SuperPower/Apollo/apollo-board_TPS63060/layout.md

#### Top Layer



#### Bottom Layer
