SuperPower/Apollo/apollo-board_TPS63060/manufacturing/BOM/BOM.xlsx

References | Qty | Value | Footprint | DNP
C1, C2 | 2 | CC0603JRX7R9BB104 | C_0603_1608Metric
C14, C15 | 2 | 2.2μF | C_0603_1608Metric
C22, C23 | 2 | CL10B104KB8NNNC | C_0603_1608Metric
C24, C25 | 2 | CC0603JRNPO9BN100 | C_0603_1608Metric
C4 | 1 | CL10B105KO8NNNC | C_0603_1608Metric
C5 | 1 | CL10B223KB8NNNC | C_0603_1608Metric
C8 | 1 | 0.1µF | C_0603_1608Metric
C16, C17, C18, C19, C20, C21 | 6 | CL21A106KAYNNNE | C_0805_2012Metric
C26, C27, C28, C29, C30, C31 | 6 | CL21A226MAQNNNE | C_0805_2012Metric
C3 | 1 | TMK212AB7475KG-T | C_0805_2012Metric
C6, C7 | 2 | CL31B106KAHNNNE | C_1206_3216Metric
R11, R17, R25, R26, R41, R42, R43, R46, R48, R51 | 10 | 1M | R_0603_1608Metric
R9, R19, R39, R54, R55 | 5 | 390k | R_0603_1608Metric
R2, R4, R18 | 3 | DNP/0 | R_0603_1608Metric | DNP
R15, R16, R24 | 3 | 10k | R_0603_1608Metric
R6, R7 | 2 | 5.1k | R_0603_1608Metric
R21, R22 | 2 | 4.7k | R_0603_1608Metric
R23, R47 | 2 | 100k | R_0603_1608Metric
R3 | 1 | 2.7k | R_0603_1608Metric
R8 | 1 | 2.2k | R_0603_1608Metric
R10 | 1 | 12k | R_0603_1608Metric
R12 | 1 | DNP/2.2k | R_0603_1608Metric | DNP
R14 | 1 | 63.4k | R_0603_1608Metric
R49 | 1 | 110k | R_0603_1608Metric
R50 | 1 | 560k | R_0603_1608Metric
R5, R20 | 2 | ERJ-6DSFR13V | R_0805_2012Metric
R1 | 1 | ERJ-P06F4700V | R_0805_2012Metric
R13 | 1 | RL0805FR-7W0R068L | R_0805_2012Metric
L2, L3 | 2 | SPM6530T-1R5M | L_TDK_SPM6530T
L1 | 1 | SPM6530T-4R7M | L_TDK_SPM6530T
D1 | 1 | DFLS230L | D_PowerDI-123
U5 | 1 | RV-3028-C7 | IC_RV-3028-C7
U4 | 1 | LTC4162EUFD-LAD | QFN-28-1EP_4x5mm_P0.5mm_EP2.65x3.65mm_ThermalVias
U6 | 1 | TPS70933DBV | SOT-23-5
U1 | 1 | AP9101CK6-AYTRG1 | SOT-23-6
U3 | 1 | IP4220CZ6 | TSOP-6_1.65x3.05mm_P0.95mm
U9, U10 | 2 | TPS63060 | Texas_S-PWSON-N10_ThermalVias_NSM_vias_bottom
U2 | 1 | TYPE-C-31-M-12 | usb-c-usb4105
SW1 | 1 | SKRKAEE020 | SKRKAEE020
LED1 | 1 | 150060VS75000_0603 | LED_0603_1608Metric
LED2 | 1 | DNP/150060YS75000_0603 | LED_0603_1608Metric | DNP
JP2 | 1 | DNP/Jumper_NC_Small | PinSocket_1x02_P2.54mm_Vertical | DNP
Q4, Q9, Q10, Q11 | 4 | 2N7002A | SOT-23
Q3, Q15 | 2 | DMN3023L | SOT-23
Q6 | 1 | BSS84-7-F | SOT-23
Q5, Q12, Q13, Q14 | 4 | DMP2035UVT | SOT-23-6
Q2 | 1 | Si3421DV | TSOP-6_1.65x3.05mm_P0.95mm
Q1 | 1 | DMN2019UTS | TSSOP-8_4.4x3mm_P0.65mm
J1 | 1 | JST_PH_S2B_thru | JST_PH_S2B-PH-K_1x02_P2.00mm_Horizontal
J4 | 1 | DNP/JST_ZH_S2B_thru | PinHeader_1x02_P1.27mm_Vertical | DNP
J5 | 1 | DNP/JST_XH_S2B_thru | PinHeader_1x02_P2.54mm_Vertical | DNP
J6 | 1 | DNP/Conn_01x02_Male | PinSocket_1x02_P2.54mm_Vertical | DNP
J11 | 1 | DNP/Conn_01x04_Male | PinSocket_1x04_P2.54mm_Vertical | DNP
J10 | 1 | Conn_01x13_Male | PinSocket_1x13_P2.54mm_Vertical
