SuperPower/Apollo/components/DMP3028LSD/DMP3028LSD-13.stp

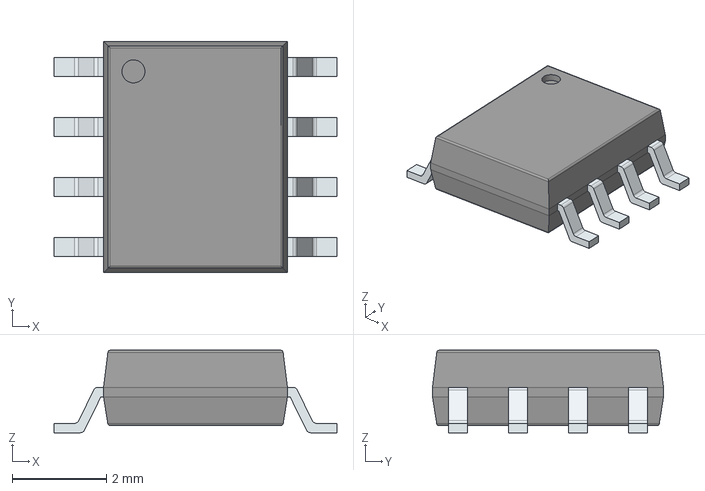
[picture p1: CAD file, 2021-02-21]
components/DMP3028LSD/DMP3028LSD-13.stp
6.00 x 4.90 x 1.75 mm
PinsArrayLR
