SuperPower/Apollo/components/PJ-102AH--3DModel-STEP-56544.STEP

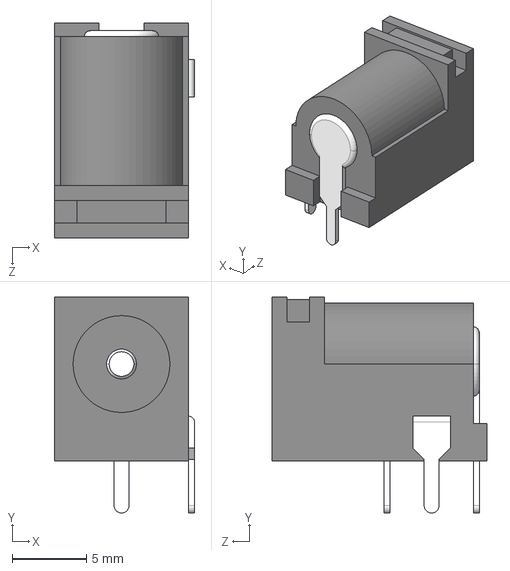
[picture p2: CAD file, 2021-02-21]
components/PJ-102AH--3DModel-STEP-56544.STEP
9.40 x 14.5 x 14.4 mm
