SuperPower/Apollo/components/RV-3028-C7/RV-3028-C7.STEP

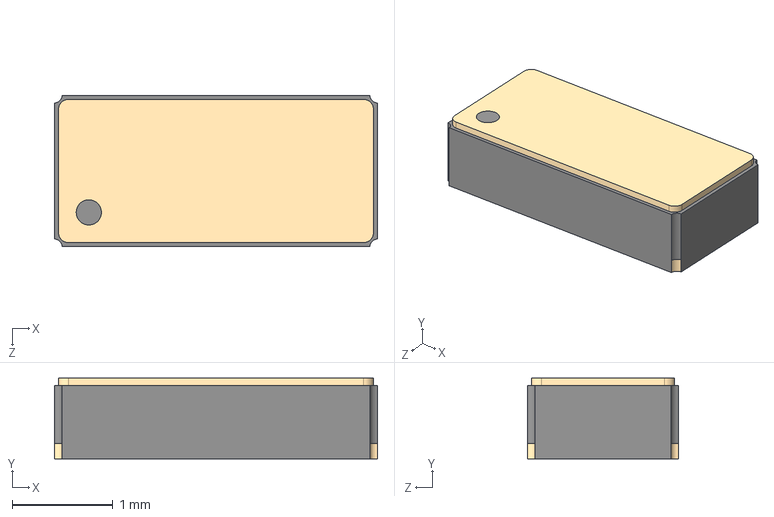
[picture p3: CAD file, 2021-02-21]
components/RV-3028-C7/RV-3028-C7.STEP
3.20 x 0.8 x 1.50 mm
