SuperPower/Apollo/components/SKRKAEE020/SKRKAEE020.stp

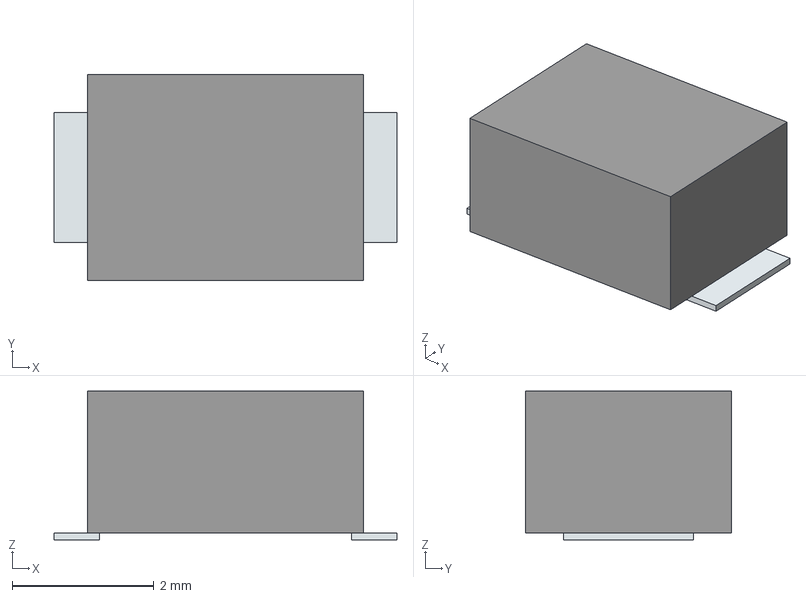
[picture p4: CAD file, 2021-02-21]
components/SKRKAEE020/SKRKAEE020.stp
4.84 x 2.90 x 2.10 mm
Pins
