SuperPower/Apollo/components/TPS63060/DSC0010E.stp

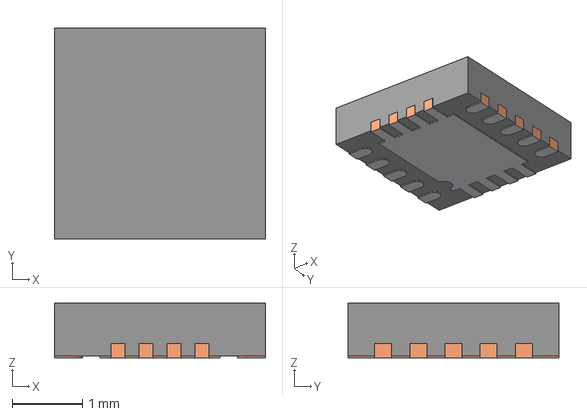
[picture p5: CAD file, 2021-02-28]
components/TPS63060/DSC0010E.stp
3.00 x 3.00 x 0.775 mm
BODY-SON
FRAME-DSC0010E
