SuperPower/Apollo/components/USB-C/USB4105.STEP

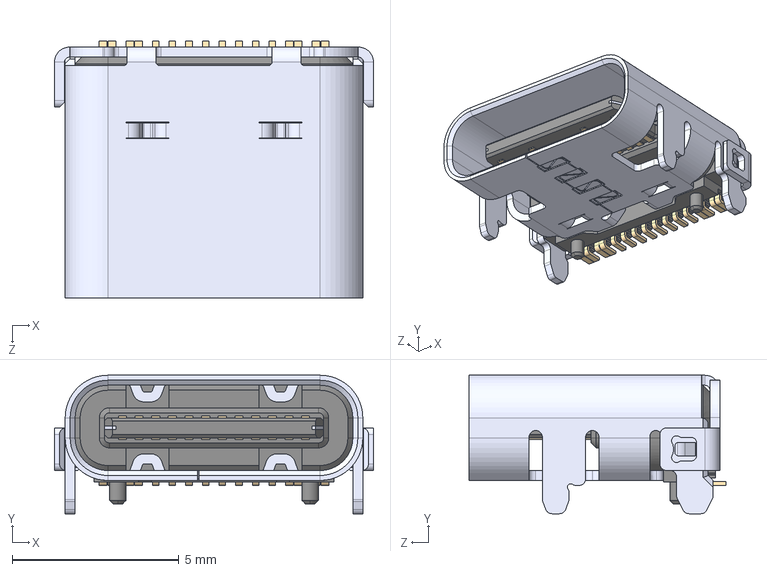
[picture p6: CAD file, 2021-02-21]
components/USB-C/USB4105.STEP
9.58 x 4.16 x 7.71 mm
