SuperPower/Apollo/components/SKRKAEE020/SKRKAE.STEP

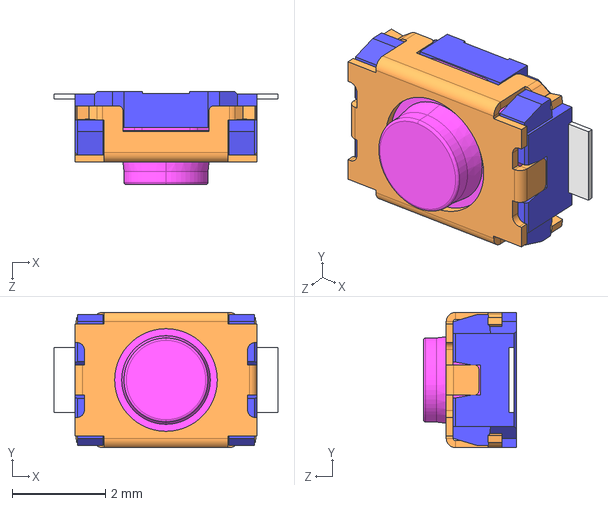
[picture p7: CAD file, 2021-02-21]
components/SKRKAEE020/SKRKAE.STEP
4.80 x 2.90 x 2.00 mm
