SuperPower/Apollo/components/USB-C/USB4110-GF-A--3DModel-STEP-56544.STEP

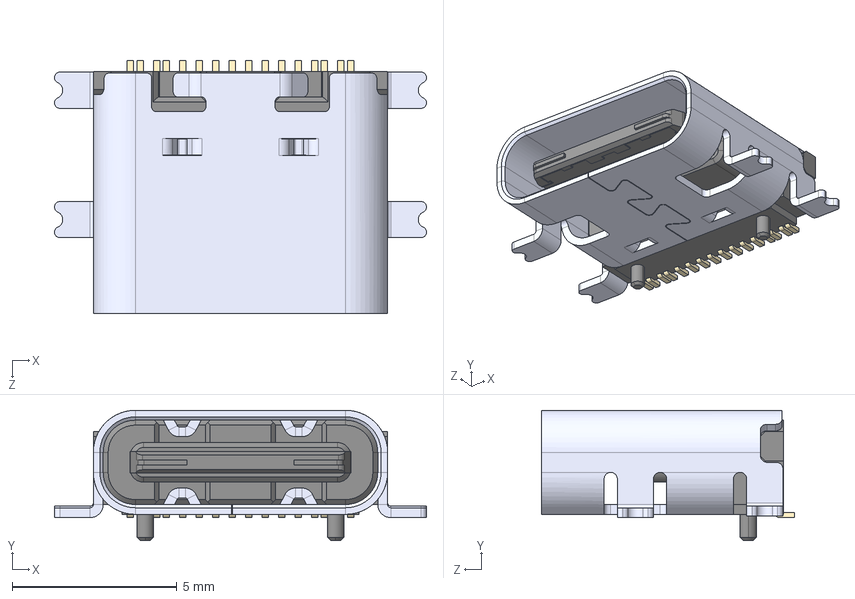
[picture p8: CAD file, 2021-02-21]
components/USB-C/USB4110-GF-A--3DModel-STEP-56544.STEP
11.3 x 3.96 x 7.68 mm
