SuperPower/Apollo/components/TPS63070RNM/TPS63070RNMT.STEP

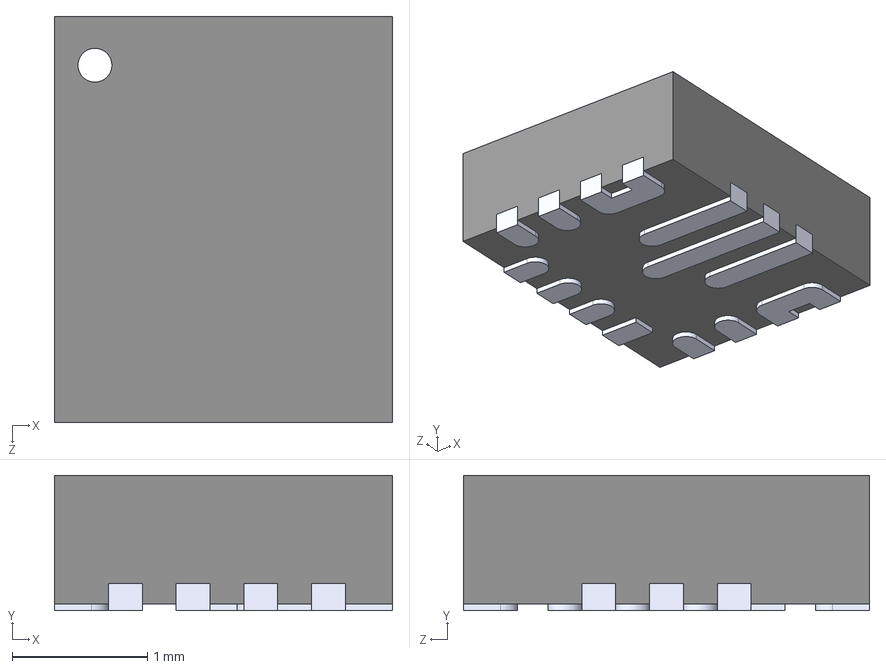
[picture p9: CAD file, 2021-02-21]
components/TPS63070RNM/TPS63070RNMT.STEP
2.50 x 1.00 x 3.00 mm
