SuperPower/Apollo/apollo-board_TPS63060/SuperPower-uC-KiCad.kicad_pcb

## KiCad design apollo-board_TPS63060/SuperPower-uC-KiCad.kicad_pcb (2021-08-04)

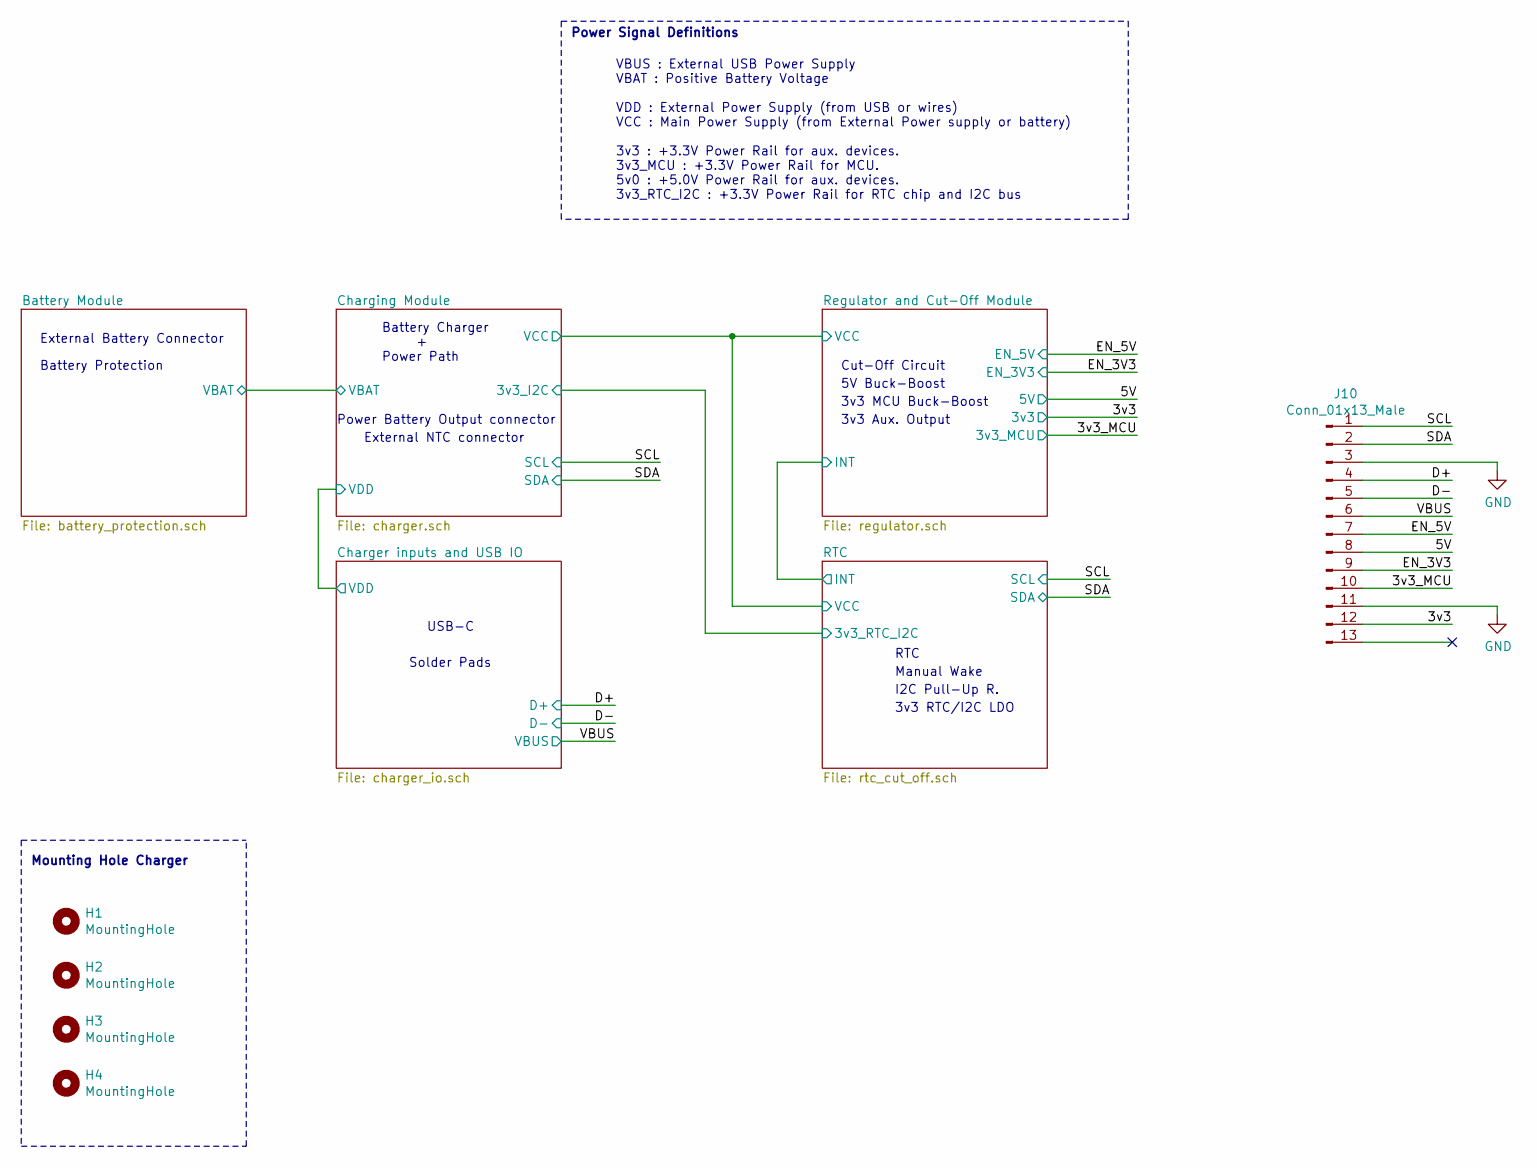
[picture p10: schematic SuperPower-uC-KiCad.sch, SuperPower-uC]

Parts:
H1, H2, H3, H4: MountingHole; MountingHole_2.5mm
J10: Conn_01x13_Male; PinSocket_1x13_P2.54mm_Vertical

Connections:
/3v3: J10.12; also elsewhere on the board
/3v3_MCU: J10.10; also elsewhere on the board
/5V: J10.8; also elsewhere on the board
/D+: J10.4; also elsewhere on the board
/D-: J10.5; also elsewhere on the board
/EN_3V3: J10.9; also elsewhere on the board
/EN_5V: J10.7; also elsewhere on the board
/SCL: J10.1; also elsewhere on the board
/SDA: J10.2; also elsewhere on the board
GND: J10.3, J10.11; also elsewhere on the board
VBUS: J10.6; also elsewhere on the board

Notes on the sheet:
External Battery Connector
Battery Protection
Battery Charger + Power Path
3v3 RTC/I2C LDO
3v3 MCU Buck-Boost
5V Buck-Boost
RTC
Cut-Off Circuit
USB-C
Solder Pads
Manual Wake
I2C Pull-Up R.
Mounting Hole Charger
Power Battery Output connector
External NTC connector
3v3 Aux. Output
VBUS : External USB Power Supply VBAT : Positive Battery Voltage VDD : External Power Supply (from USB or wires) VCC : Main Power Supply (from External Power supply or battery) 3v3 : +3.3V Power Rail for aux. devices. 3v3_MCU : +3.3V Power Rail for MCU. 5v0 : +5.0V Power Rail for aux. devices. 3v3_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
Power Signal Definitions

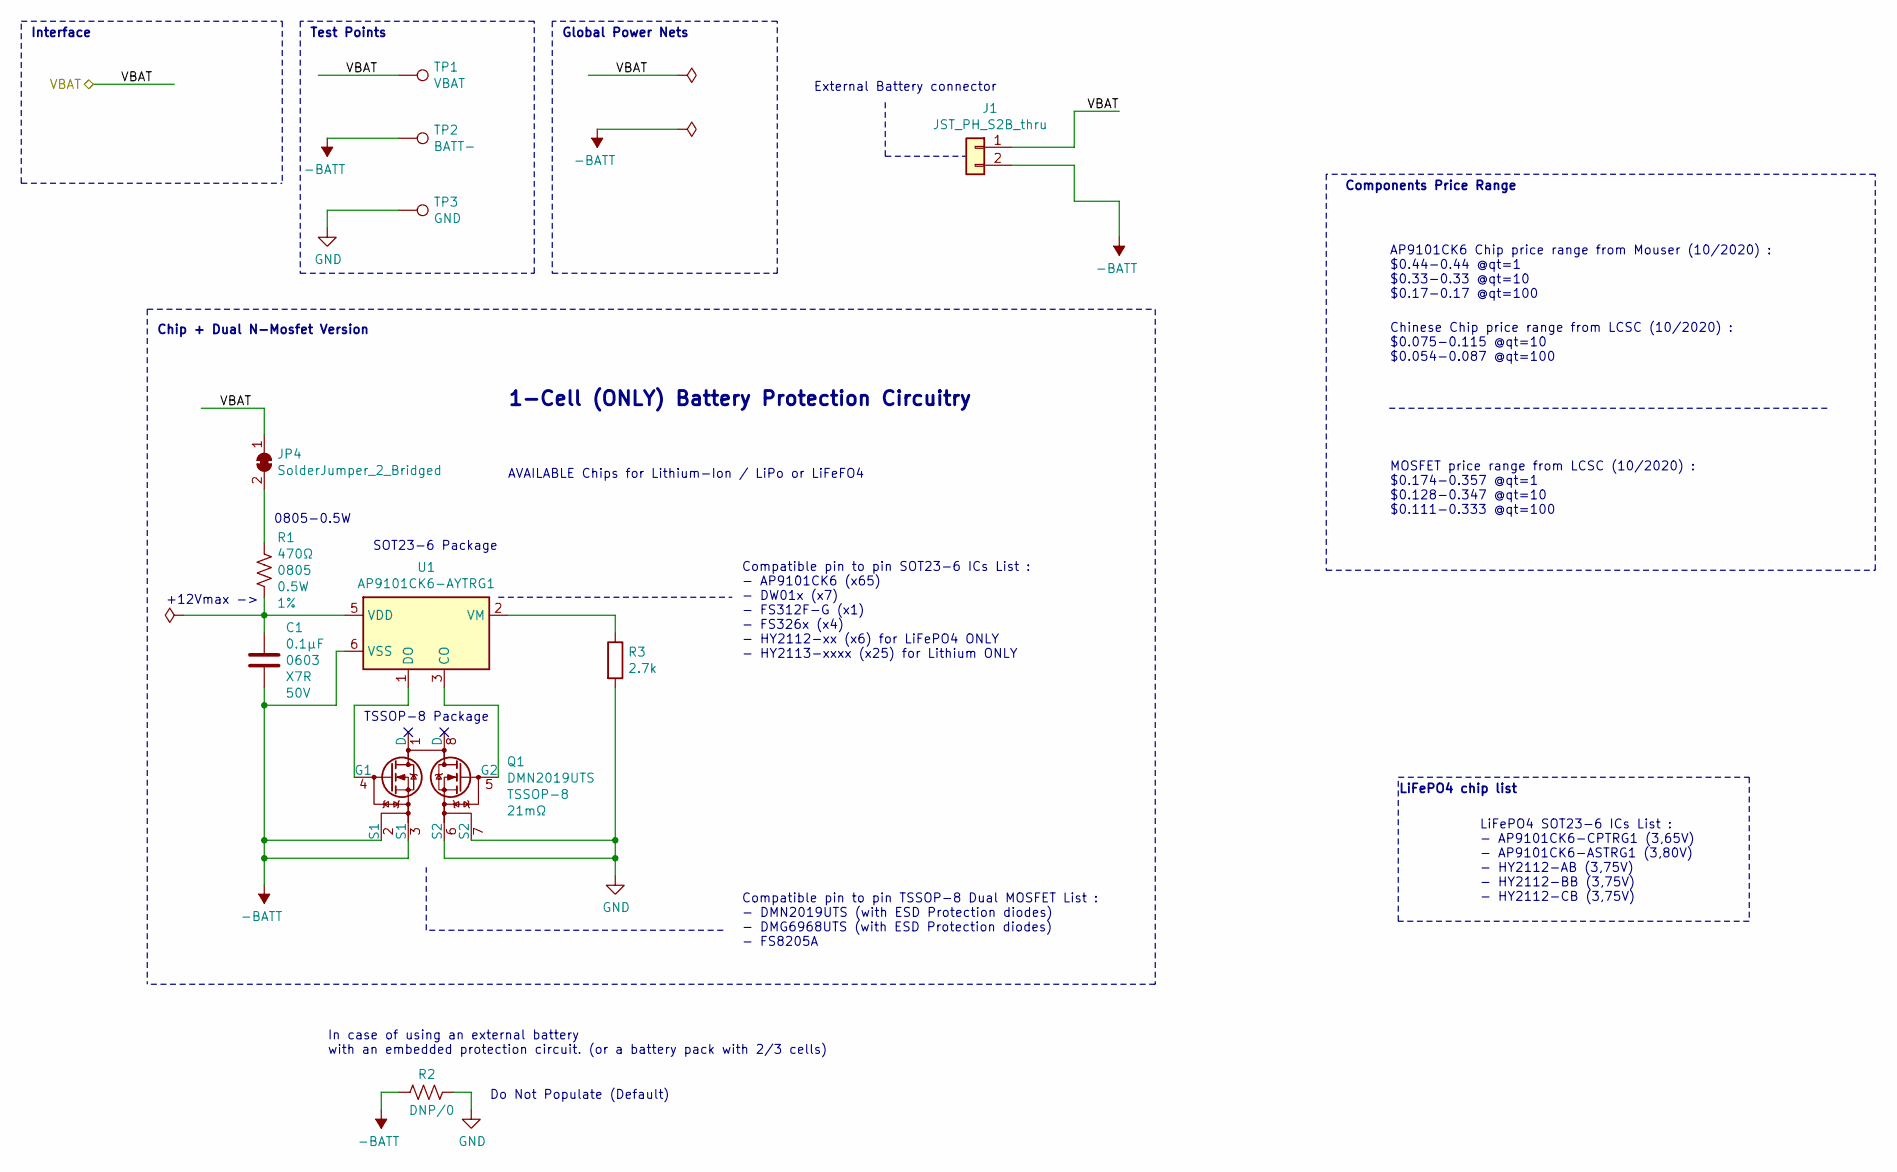
[picture p11: schematic battery_protection.sch, SuperPower-uC]

Parts:
C1: CC0603JRX7R9BB104; C_0603_1608Metric; Farnell_ref 3369214
J1: JST_PH_S2B_thru; JST_PH_S2B-PH-K_1x02_P2.00mm_Horizontal; Farnell_ref 9491902
JP4: SolderJumper_2_Bridged; SolderJumper-2_P1.3mm_Bridged_RoundedPad1.0x1.5mm
Q1: DMN2019UTS; TSSOP-8_4.4x3mm_P0.65mm; Farnell_check_date 2020-12-05
R1: ERJ-P06F4700V; R_0805_2012Metric; Farnell_check_date 2020-12-17
R2: DNP/0; R_0603_1608Metric
R3: 2.7k; R_0603_1608Metric
TP1: VBAT; TestPoint_Pad_D1.0mm
TP2: BATT-; TestPoint_Pad_D1.0mm
TP3: GND; TestPoint_Pad_D1.0mm
U1: AP9101CK6-AYTRG1; SOT-23-6; Farnell_check_date 2020-11-28

Connections:
-BATT: C1.2, J1.2, Q1.2 (S1), Q1.3 (S1), R2.2, TP2.1, U1.6 (VSS)
/Battery Module/VBAT: J1.1, JP4.1 (A), TP1.1; also elsewhere on the board
GND: Q1.6 (S2), Q1.7 (S2), R2.1, R3.2, TP3.1; also elsewhere on the board
unnamed: C1.1, R1.2, U1.5 (VDD)
unnamed: JP4.2 (B), R1.1
unnamed: Q1.4 (G1), U1.1 (DO)
unnamed: Q1.5 (G2), U1.3 (CO)
unnamed: R3.1, U1.2 (VM)

Notes on the sheet:
SOT23-6 Package
TSSOP-8 Package
Compatible pin to pin SOT23-6 ICs List : - AP9101CK6 (x65) - DW01x (x7) - FS312F-G (x1) - FS326x (x4) - HY2112-xx (x6) for LiFePO4 ONLY - HY2113-xxxx (x25) for Lithium ONLY
AVAILABLE Chips for Lithium-Ion / LiPo or LiFeFO4
AP9101CK6 Chip price range from Mouser (10/2020) : $0.44-0.44 @qt=1 $0.33-0.33 @qt=10 $0.17-0.17 @qt=100
Compatible pin to pin TSSOP-8 Dual MOSFET List : - DMN2019UTS (with ESD Protection diodes) - DMG6968UTS (with ESD Protection diodes) - FS8205A
MOSFET price range from LCSC (10/2020) : $0.174-0.357 @qt=1 $0.128-0.347 @qt=10 $0.111-0.333 @qt=100
LiFePO4 SOT23-6 ICs List : - AP9101CK6-CPTRG1 (3,65V) - AP9101CK6-ASTRG1 (3,80V) - HY2112-AB (3,75V) - HY2112-BB (3,75V) - HY2112-CB (3,75V)
Chinese Chip price range from LCSC (10/2020) : $0.075-0.115 @qt=10 $0.054-0.087 @qt=100
Chip + Dual N-Mosfet Version
LiFePO4 chip list
In case of using an external battery with an embedded protection circuit. (or a battery pack with 2/3 cells)
External Battery connector
Interface
Components Price Range
1-Cell (ONLY) Battery Protection Circuitry
+12Vmax ->
Do Not Populate (Default)
0805-0.5W
Test Points
Global Power Nets

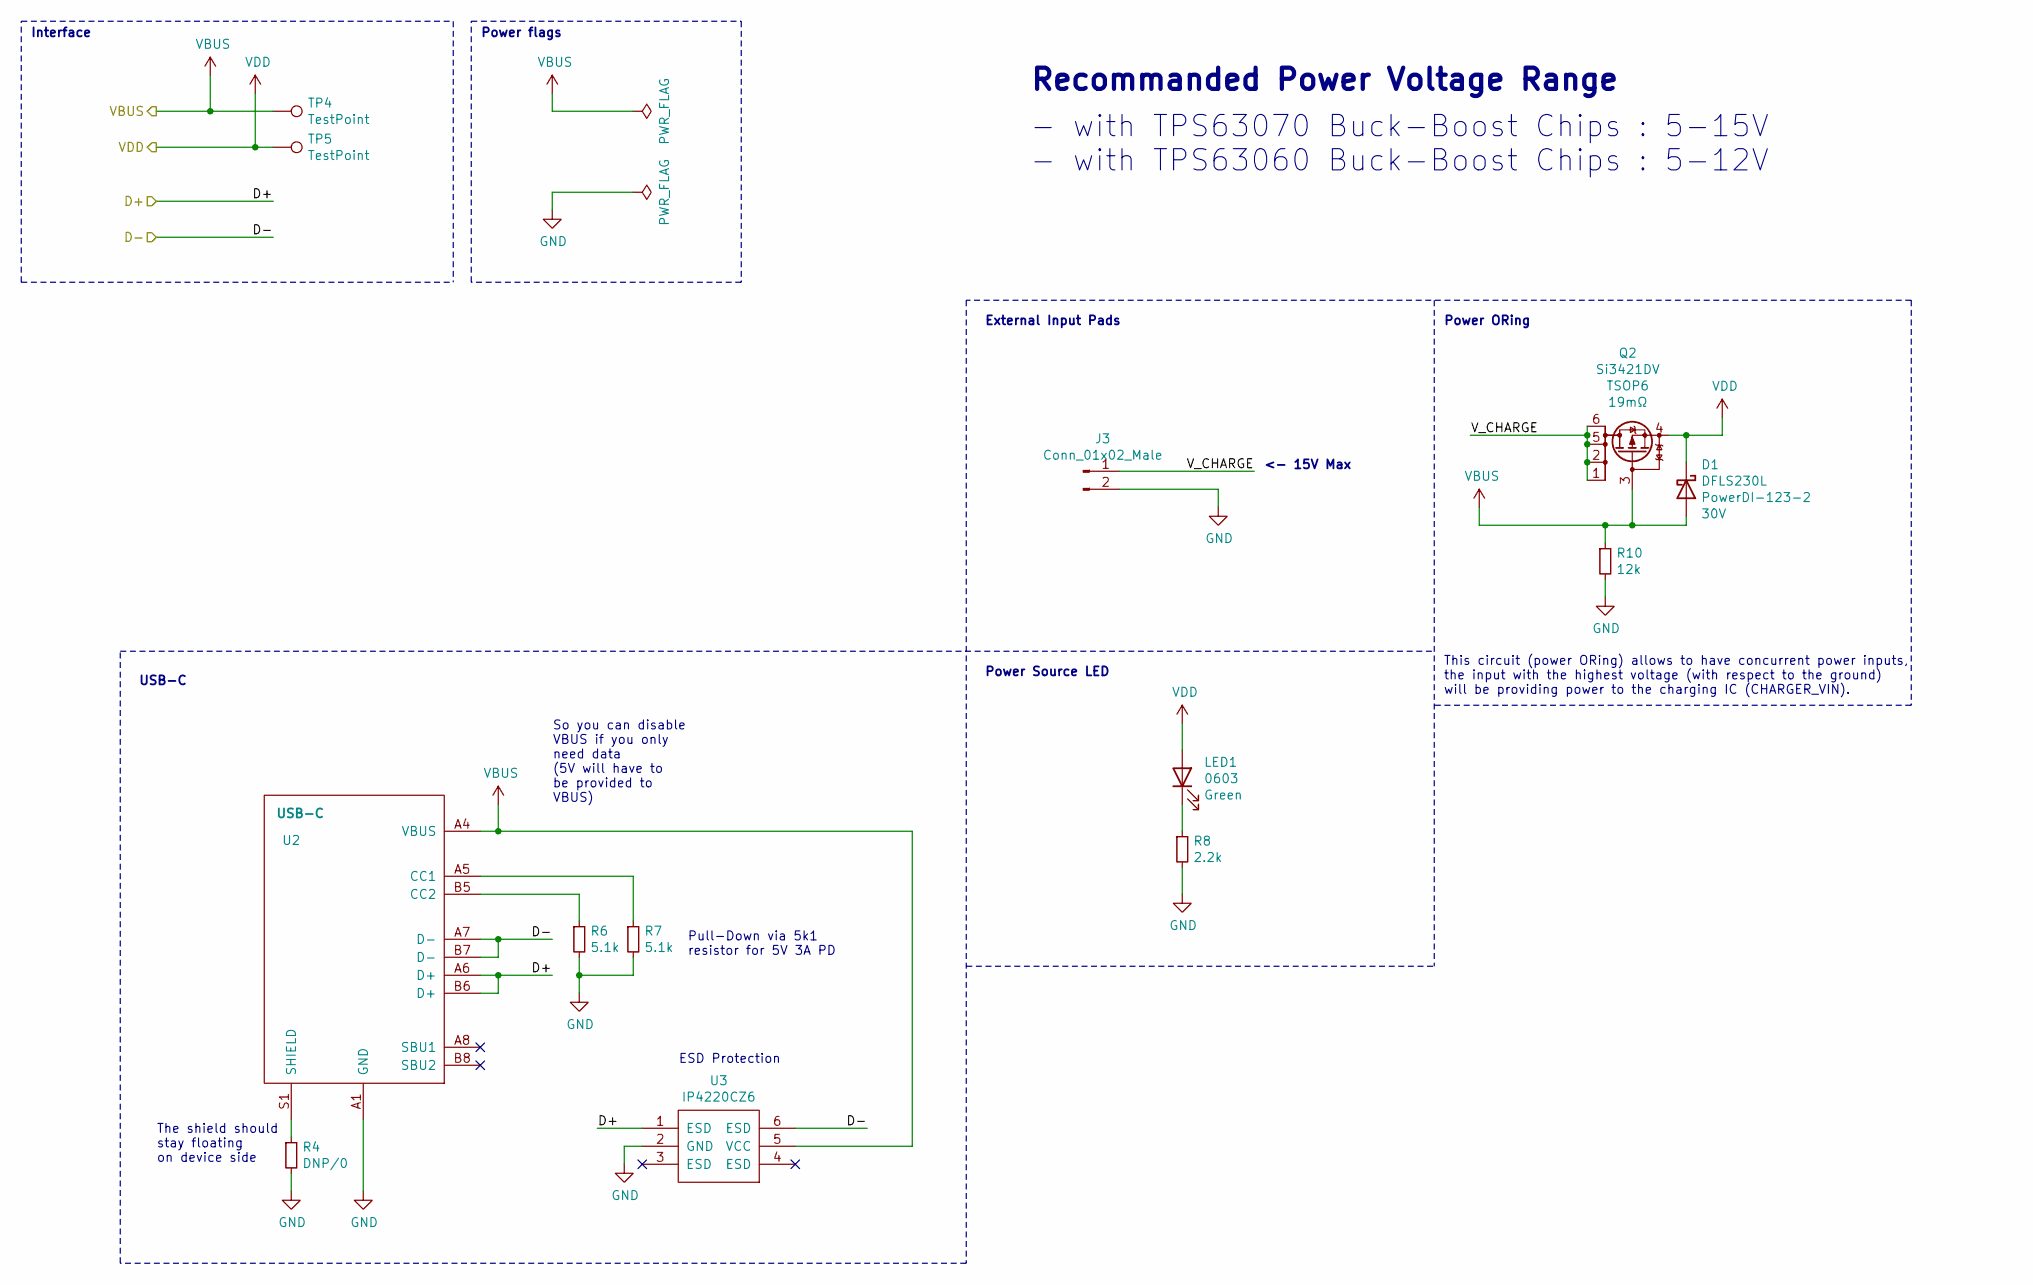
[picture p12: schematic charger_io.sch, SuperPower-uC]

Parts:
D1: DFLS230L; D_PowerDI-123; Farnell_ref 1858663
J3: Conn_01x02_Male; ext_input_pads
LED1: 150060VS75000_0603; LED_0603_1608Metric; Farnell_ref 2322073
Q2: Si3421DV; TSOP-6_1.65x3.05mm_P0.95mm; Farnell_ref 3405183
R4: DNP/0; R_0603_1608Metric
R6, R7: 5.1k; R_0603_1608Metric
R8: 2.2k; R_0603_1608Metric
R10: 12k; R_0603_1608Metric
TP4, TP5: TestPoint; TestPoint_Pad_D1.0mm
U2: USB-C; usb-c-usb4105
U3: IP4220CZ6; TSOP-6_1.65x3.05mm_P0.95mm

Connections:
/Charger inputs and USB IO/V_CHARGE: J3.1, Q2.1 (D), Q2.2 (D), Q2.5 (D), Q2.6 (D)
/D+: U2.A6 (D+), U2.B6 (D+), U3.1 (ESD); also elsewhere on the board
/D-: U2.A7 (D-), U2.B7 (D-), U3.6 (ESD); also elsewhere on the board
GND: J3.2, R4.2, R6.2, R7.2, R8.2, R10.2, U2.A1 (GND), U2.A12 (GND), U2.B1 (GND), U2.B12 (GND), U3.2 (GND); also elsewhere on the board
unnamed: LED1.1 (K), R8.1
unnamed: R4.1, U2.S1 (SHIELD)
unnamed: R6.1, U2.B5 (CC2)
unnamed: R7.1, U2.A5 (CC1)
VBUS: D1.2 (A), Q2.3 (G), R10.1, TP4.1, U2.A4 (VBUS), U2.A9 (VBUS), U2.B4 (VBUS), U2.B9 (VBUS), U3.5 (VCC); also elsewhere on the board
VDD: D1.1 (K), LED1.2 (A), Q2.4 (S), TP5.1; also elsewhere on the board

Notes on the sheet:
Pull-Down via 5k1 resistor for 5V 3A PD
External Input Pads
USB-C
So you can disable VBUS if you only need data (5V will have to be provided to VBUS)
ESD Protection
The shield should stay floating on device side
Power ORing
This circuit (power ORing) allows to have concurrent power inputs, the input with the highest voltage (with respect to the ground) will be providing power to the charging IC (CHARGER_VIN).
Power Source LED
Interface
Recommanded Power Voltage Range
<- 15V Max
Power flags
- with TPS63070 Buck-Boost Chips : 5-15V - with TPS63060 Buck-Boost Chips : 5-12V

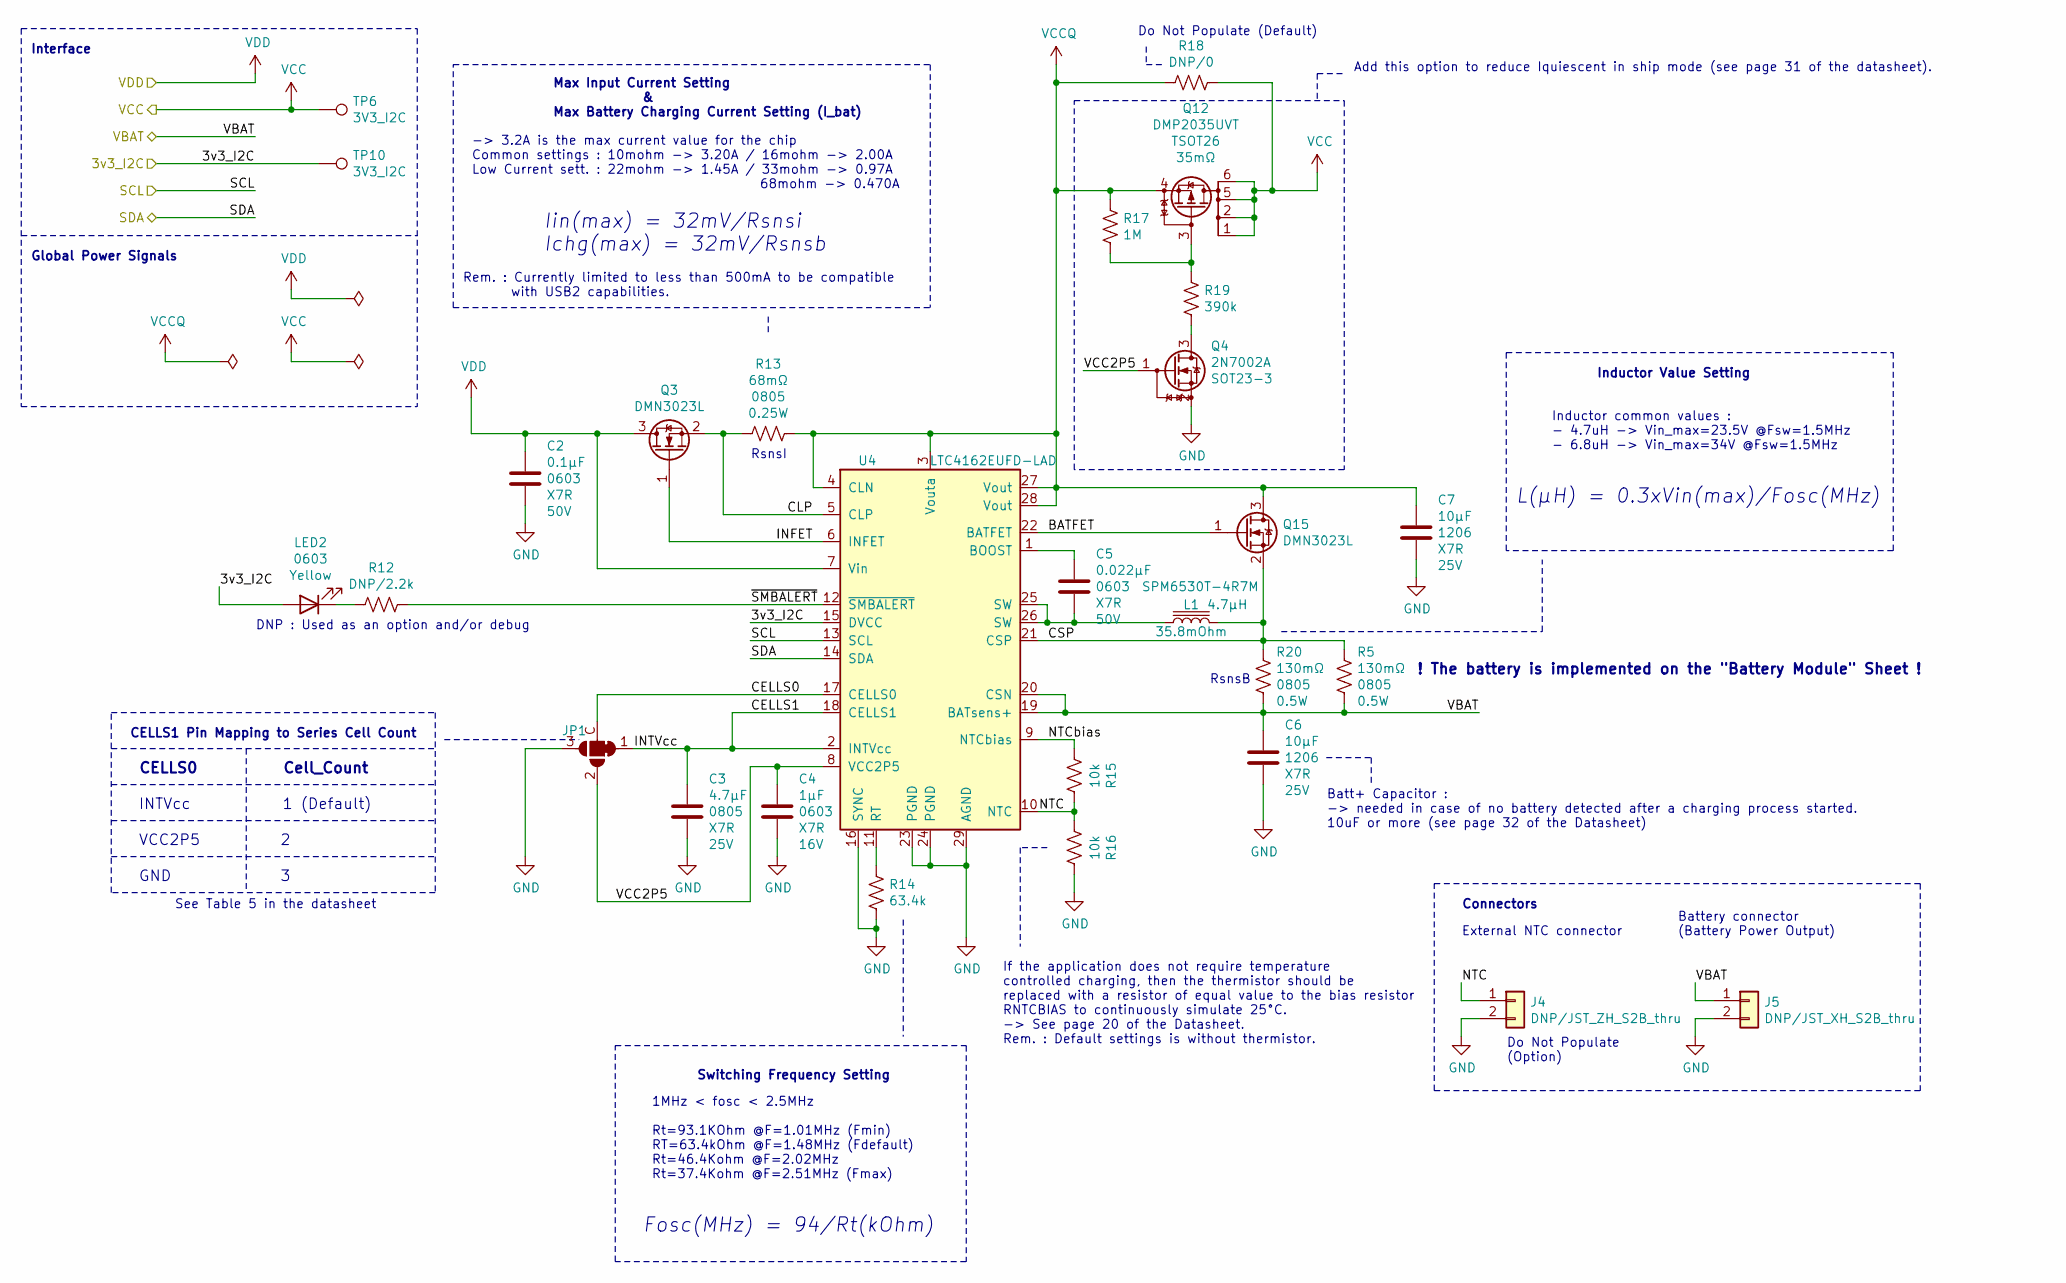
[picture p13: schematic charger.sch, SuperPower-uC]

Parts:
C2: CC0603JRX7R9BB104; C_0603_1608Metric; Farnell_ref 3369214
C3: TMK212AB7475KG-T; C_0805_2012Metric; Farnell_ref 2779199
C4: CL10B105KO8NNNC; C_0603_1608Metric; Farnell_ref 3013416
C5: CL10B223KB8NNNC; C_0603_1608Metric; Farnell_ref 3013425
C6, C7: CL31B106KAHNNNE; C_1206_3216Metric; Farnell_ref 3013526
J4: DNP/JST_ZH_S2B_thru; PinHeader_1x02_P1.27mm_Vertical; Farnell_ref 9491813
J5: DNP/JST_XH_S2B_thru; PinHeader_1x02_P2.54mm_Vertical; Farnell_ref 1516289
JP1: SolderJumper_4_Bridged_1C; SolderJumper-4_P2.0mm_Bridged1C_TrianglePad1.0x1.5mm_Number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
L1: SPM6530T-4R7M; L_TDK_SPM6530T; LCSC_ref C76857
LED2: 150060YS75000_0603; LED_0603_1608Metric; Farnell_ref 2322074
Q3, Q15: DMN3023L; SOT-23
Q4: 2N7002A; SOT-23; Farnell_ref 3127180
Q12: DMP2035UVT; SOT-23-6; Farnell_ref 3405183
R5, R20: ERJ-6DSFR13V; R_0805_2012Metric; Farnell_check_date 2021-08-02
R12: DNP/2.2k; R_0603_1608Metric
R13: RL0805FR-7W0R068L; R_0805_2012Metric; Farnell_ref 8067694
R14: 63.4k; R_0603_1608Metric
R15, R16: 10k; R_0603_1608Metric
R17: 1M; R_0603_1608Metric
R18: DNP/0; R_0603_1608Metric
R19: 390k; R_0603_1608Metric
TP6, TP10: 3V3_I2C; TestPoint_Pad_D1.0mm
U4: LTC4162EUFD-LAD; QFN-28-1EP_4x5mm_P0.5mm_EP2.65x3.65mm_ThermalVias; Farnell_check_date 2020-11-22

Connections:
/Battery Module/VBAT: C6.1, J5.1, R5.2, R20.2, U4.19 (BATsens+), U4.20 (CSN); also elsewhere on the board
/Charging Module/3v3_I2C: LED2.2 (A), TP10.1, U4.15 (DVCC); also elsewhere on the board
/Charging Module/BATFET: Q15.1 (G), U4.22 (BATFET)
/Charging Module/CELLS0: JP1.C (Com), U4.17 (CELLS0)
/Charging Module/CELLS1: C3.1, JP1.1 (A), U4.2 (INTVcc), U4.18 (CELLS1)
/Charging Module/CLP: Q3.2 (S), R13.2, U4.5 (CLP)
/Charging Module/CSP: L1.2, Q15.2 (S), R5.1, R20.1, U4.21 (CSP)
/Charging Module/INFET: Q3.1 (G), U4.6 (INFET)
/Charging Module/NTC: J4.1, R15.1, R16.2, U4.10 (NTC)
/Charging Module/NTCbias: R15.2, U4.9 (NTCbias)
/Charging Module/VCC2P5: C4.1, JP1.2 (B), Q4.1 (G), U4.8 (VCC2P5)
/Charging Module/~SMBALERT: R12.1, U4.12 (~SMBALERT)
/SCL: U4.13 (SCL); also elsewhere on the board
/SDA: U4.14 (SDA); also elsewhere on the board
GND: C2.2, C3.2, C4.2, C6.2, C7.2, J4.2, J5.2, JP1.3 (C), Q4.2 (S), R14.1, R16.1, U4.16 (SYNC), U4.23 (PGND), U4.24 (PGND), U4.29 (AGND); also elsewhere on the board
unnamed: C5.1, U4.1 (BOOST)
unnamed: C5.2, L1.1, U4.25 (SW), U4.26 (SW)
unnamed: LED2.1 (K), R12.2
unnamed: Q4.3 (D), R19.2
unnamed: Q12.3 (G), R17.2, R19.1
unnamed: R14.2, U4.11 (RT)
VCC: Q12.1 (D), Q12.2 (D), Q12.5 (D), Q12.6 (D), R18.1, TP6.1; also elsewhere on the board
VCCQ: C7.1, Q12.4 (S), Q15.3 (D), R13.1, R17.1, R18.2, U4.3 (Vouta), U4.4 (CLN), U4.27 (Vout), U4.28 (Vout)
VDD: C2.1, Q3.3 (D), U4.7 (Vin); also elsewhere on the board

Notes on the sheet:
RsnsB
RsnsI
If the application does not require temperature controlled charging, then the thermistor should be replaced with a resistor of equal value to the bias resistor RNTCBIAS to continuously simulate 25°C. -> See page 20 of the Datasheet. Rem. : Default settings is without thermistor.
Batt+ Capacitor : -> needed in case of no battery detected after a charging process started. 10uF or more (see page 32 of the Datasheet)
1MHz < fosc < 2.5MHz Rt=93.1KOhm @F=1.01MHz (Fmin) RT=63.4kOhm @F=1.48MHz (Fdefault) Rt=46.4Kohm @F=2.02MHz Rt=37.4Kohm @F=2.51MHz (Fmax)
Inductor common values : - 4.7uH -> Vin_max=23.5V @Fsw=1.5MHz - 6.8uH -> Vin_max=34V @Fsw=1.5MHz
Add this option to reduce Iquiescent in ship mode (see page 31 of the datasheet).
External NTC connector
Switching Frequency Setting
Max Input Current Setting & Max Battery Charging Current Setting (I_bat)
-> 3.2A is the max current value for the chip Common settings : 10mohm -> 3.20A / 16mohm -> 2.00A Low Current sett. : 22mohm -> 1.45A / 33mohm -> 0.97A 68mohm -> 0.470A
Inductor Value Setting
Battery connector (Battery Power Output)
DNP : Used as an option and/or debug
See Table 5 in the datasheet
Connectors
! The battery is implemented on the "Battery Module" Sheet !
Iin(max) = 32mV/Rsnsi Ichg(max) = 32mV/Rsnsb
Fosc(MHz) = 94/Rt(kOhm)
L(µH) = 0.3xVin(max)/Fosc(MHz)
CELLS1 Pin Mapping to Series Cell Count
CELLS0
Cell_Count
INTVcc
VCC2P5
GND
1 (Default)
Rem. : Currently limited to less than 500mA to be compatible with USB2 capabilities.
Interface
Do Not Populate (Option)
Do Not Populate (Default)
Global Power Signals

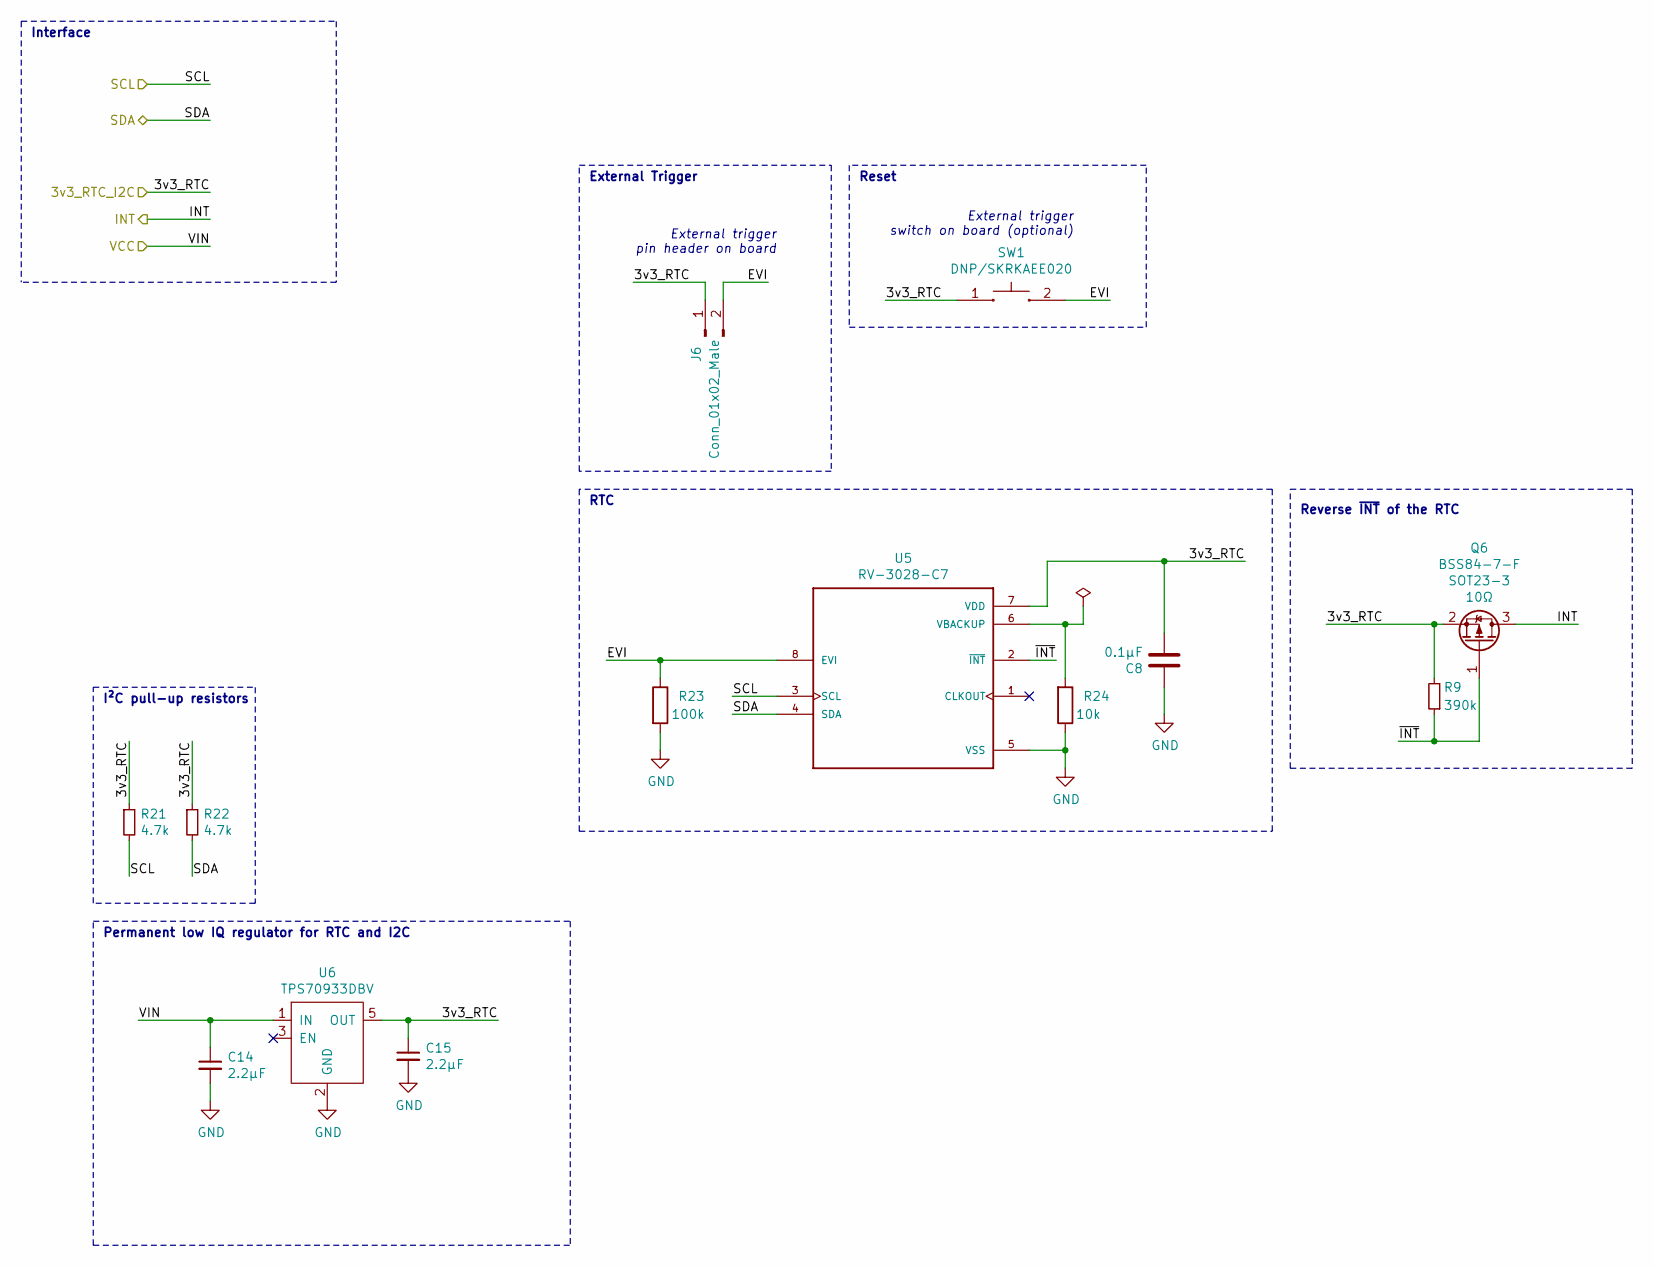
[picture p14: schematic rtc_cut_off.sch, SuperPower-uC]

Parts:
C8: 0.1µF; C_0603_1608Metric
C14, C15: 2.2μF; C_0603_1608Metric
J6: Conn_01x02_Male; PinSocket_1x02_P2.54mm_Vertical
Q6: BSS84-7-F; SOT-23; Farnell_ref 1843716
R9: 390k; R_0603_1608Metric
R21, R22: 4.7k; R_0603_1608Metric
R23: 100k; R_0603_1608Metric
R24: 10k; R_0603_1608Metric
SW1: DNP/SKRKAEE020; SKRKAEE020
U5: RV-3028-C7; IC_RV-3028-C7
U6: TPS70933DBV; SOT-23-5

Connections:
/Charging Module/3v3_I2C: C8.2, C15.1, J6.1, Q6.2 (S), R9.2, R21.1, R22.1, SW1.1, U5.7 (VDD), U6.5 (OUT); also elsewhere on the board
/RTC/EVI: J6.2, R23.1, SW1.2, U5.8 (EVI)
/RTC/INT: Q6.3 (D); also elsewhere on the board
/RTC/~INT: Q6.1 (G), R9.1, U5.2 (~INT~)
/SCL: R21.2, U5.3 (SCL); also elsewhere on the board
/SDA: R22.2, U5.4 (SDA); also elsewhere on the board
GND: C8.1, C14.2, C15.2, R23.2, R24.1, U5.5 (VSS), U6.2 (GND); also elsewhere on the board
unnamed: R24.2, U5.6 (VBACKUP)
VCC: C14.1, U6.1 (IN); also elsewhere on the board

Notes on the sheet:
I²C pull-up resistors
External trigger pin header on board
Interface
External trigger switch on board (optional)
RTC
Reset
External Trigger
Reverse ~INT~ of the RTC
Permanent low IQ regulator for RTC and I2C

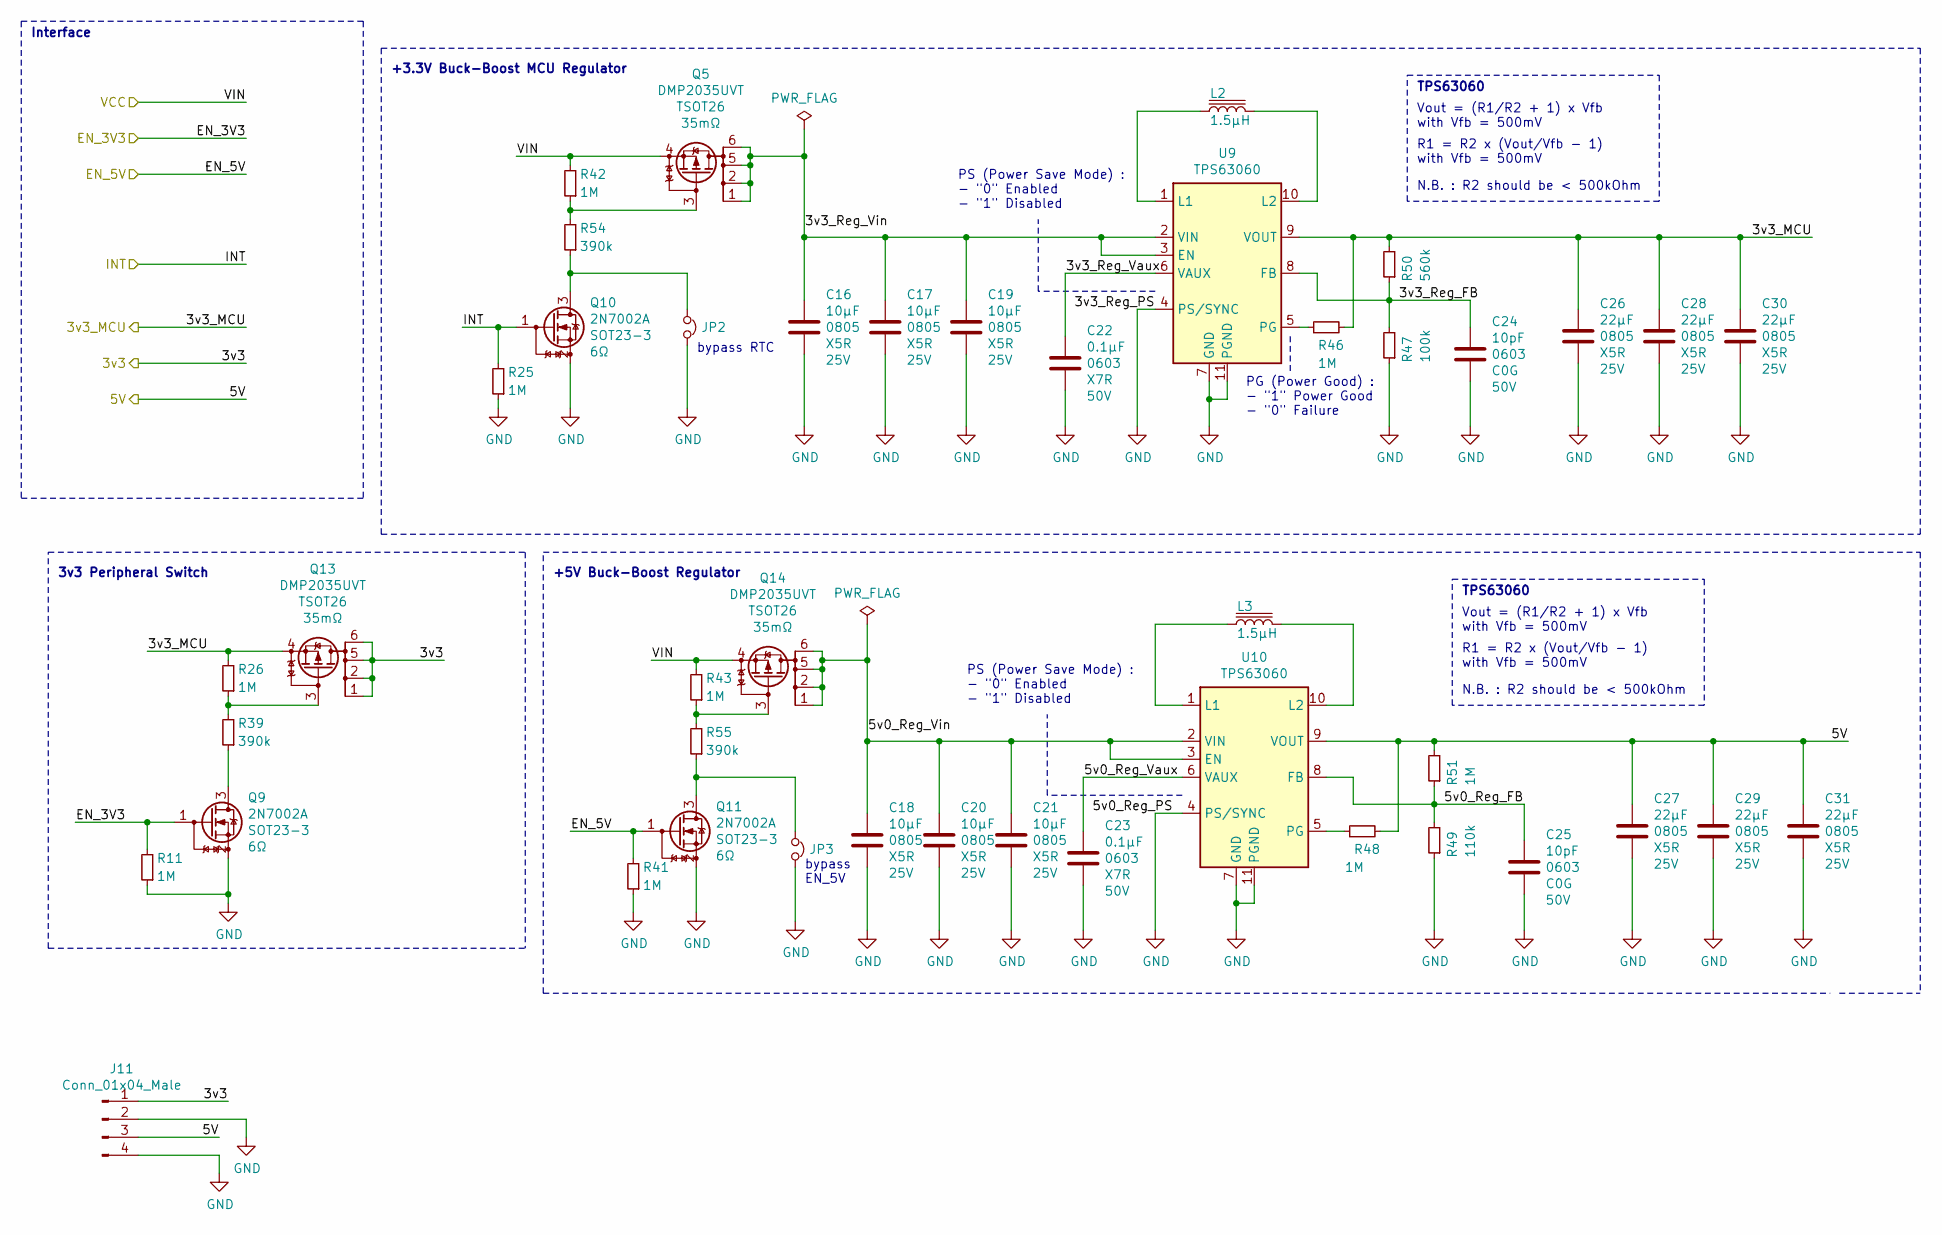
[picture p15: schematic regulator.sch, SuperPower-uC]

Parts:
C16, C17, C18, C19, C20, C21: CL21A106KAYNNNE; C_0805_2012Metric; Farnell_ref 3013452
C22, C23: CL10B104KB8NNNC; C_0603_1608Metric; Farnell_check_date 2021-02-23
C24, C25: CC0603JRNPO9BN100; C_0603_1608Metric; Farnell_ref 721967
C26, C27, C28, C29, C30, C31: CL21A226MAQNNNE; C_0805_2012Metric; Farnell_ref 3013459
J11: Conn_01x04_Male; PinSocket_1x04_P2.54mm_Vertical
JP2: Jumper_NC_Small; PinSocket_1x02_P2.54mm_Vertical
JP3: Jumper_NC_Small; SolderJumper-2_P1.3mm_Open_TrianglePad1.0x1.5mm
L2, L3: SPM6530T-1R5M; L_TDK_SPM6530T; Farnell_ref 2215610
Q5, Q13, Q14: DMP2035UVT; SOT-23-6; Farnell_ref 3405183
Q9, Q10, Q11: 2N7002A; SOT-23; Farnell_ref 3127180
R11, R25, R26, R41, R42, R43, R46, R48, R51: 1M; R_0603_1608Metric
R39, R54, R55: 390k; R_0603_1608Metric
R47: 100k; R_0603_1608Metric
R49: 110k; R_0603_1608Metric
R50: 560k; R_0603_1608Metric
U9, U10: TPS63060; Texas_S-PWSON-N10_ThermalVias_NSM_vias_bottom

Connections:
/3v3: J11.1, Q13.1 (D), Q13.2 (D), Q13.5 (D), Q13.6 (D); also elsewhere on the board
/3v3_MCU: C26.1, C28.1, C30.1, Q13.4 (S), R26.2, R46.2, R50.2, U9.9 (VOUT); also elsewhere on the board
/5V: C27.1, C29.1, C31.1, J11.3, R48.2, R51.2, U10.9 (VOUT); also elsewhere on the board
/EN_3V3: Q9.1 (G), R11.2; also elsewhere on the board
/EN_5V: Q11.1 (G), R41.2; also elsewhere on the board
/RTC/INT: Q10.1 (G), R25.2; also elsewhere on the board
/Regulator and Cut-Off Module/3v3_Reg_FB: C24.1, R47.2, R50.1, U9.8 (FB)
/Regulator and Cut-Off Module/3v3_Reg_Vaux: C22.1, U9.6 (VAUX)
/Regulator and Cut-Off Module/3v3_Reg_Vin: C16.1, C17.1, C19.1, Q5.1 (D), Q5.2 (D), Q5.5 (D), Q5.6 (D), U9.2 (VIN), U9.3 (EN)
/Regulator and Cut-Off Module/5v0_Reg_FB: C25.1, R49.2, R51.1, U10.8 (FB)
/Regulator and Cut-Off Module/5v0_Reg_Vaux: C23.1, U10.6 (VAUX)
/Regulator and Cut-Off Module/5v0_Reg_Vin: C18.1, C20.1, C21.1, Q14.1 (D), Q14.2 (D), Q14.5 (D), Q14.6 (D), U10.2 (VIN), U10.3 (EN)
GND: C16.2, C17.2, C18.2, C19.2, C20.2, C21.2, C22.2, C23.2, C24.2, C25.2, C26.2, C27.2, C28.2, C29.2, C30.2, C31.2, J11.2, J11.4, JP2.2, JP3.2, Q9.2 (S), Q10.2 (S), Q11.2 (S), R11.1, R25.1, R41.1, R47.1, R49.1, U9.4 (PS/SYNC), U9.7 (GND), U9.11 (PGND), U10.4 (PS/SYNC), U10.7 (GND), U10.11 (PGND); also elsewhere on the board
unnamed: JP2.1, Q10.3 (D), R54.1
unnamed: JP3.1, Q11.3 (D), R55.1
unnamed: L2.1, U9.1 (L1)
unnamed: L2.2, U9.10 (L2)
unnamed: L3.1, U10.1 (L1)
unnamed: L3.2, U10.10 (L2)
unnamed: Q5.3 (G), R42.1, R54.2
unnamed: Q9.3 (D), R39.1
unnamed: Q13.3 (G), R26.1, R39.2
unnamed: Q14.3 (G), R43.1, R55.2
unnamed: R46.1, U9.5 (PG)
unnamed: R48.1, U10.5 (PG)
VCC: Q5.4 (S), Q14.4 (S), R42.2, R43.2; also elsewhere on the board

Notes on the sheet:
Interface
+5V Buck-Boost Regulator
bypass EN_5V
bypass RTC
+3.3V Buck-Boost MCU Regulator
3v3 Peripheral Switch
PS (Power Save Mode) : - "0" Enabled - "1" Disabled
PG (Power Good) : - "1" Power Good - "0" Failure
Vout = (R1/R2 + 1) x Vfb with Vfb = 500mV
N.B. : R2 should be < 500kOhm
R1 = R2 x (Vout/Vfb - 1) with Vfb = 500mV
TPS63060

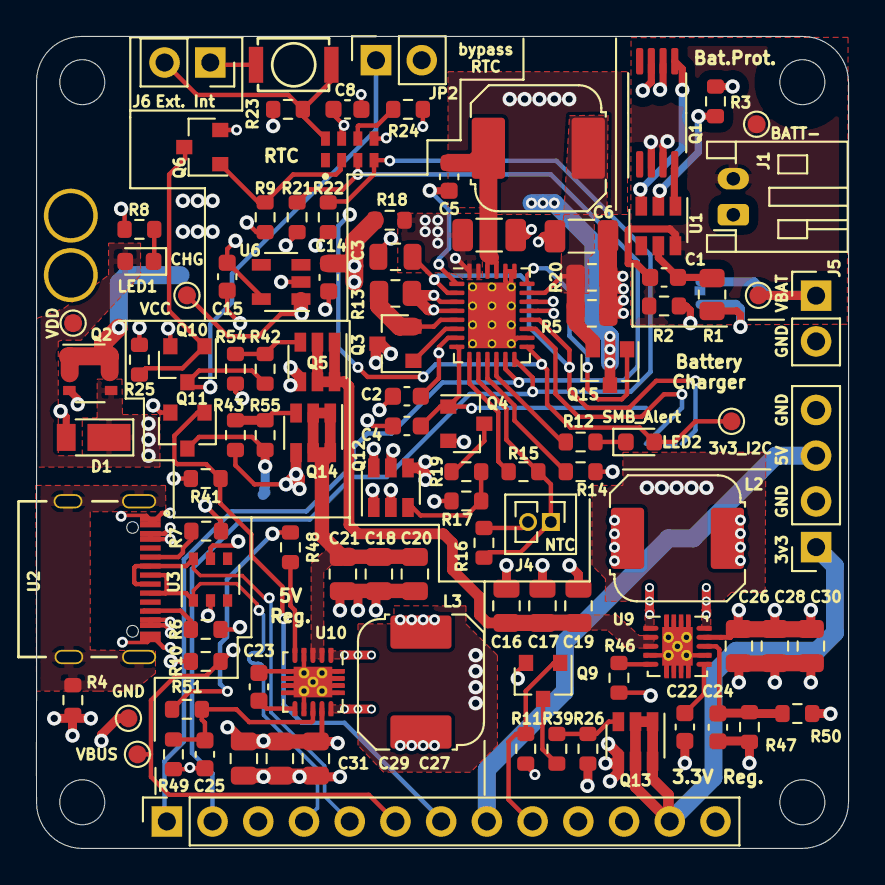
[picture p16: board SuperPower-uC-KiCad.kicad_pcb from above]

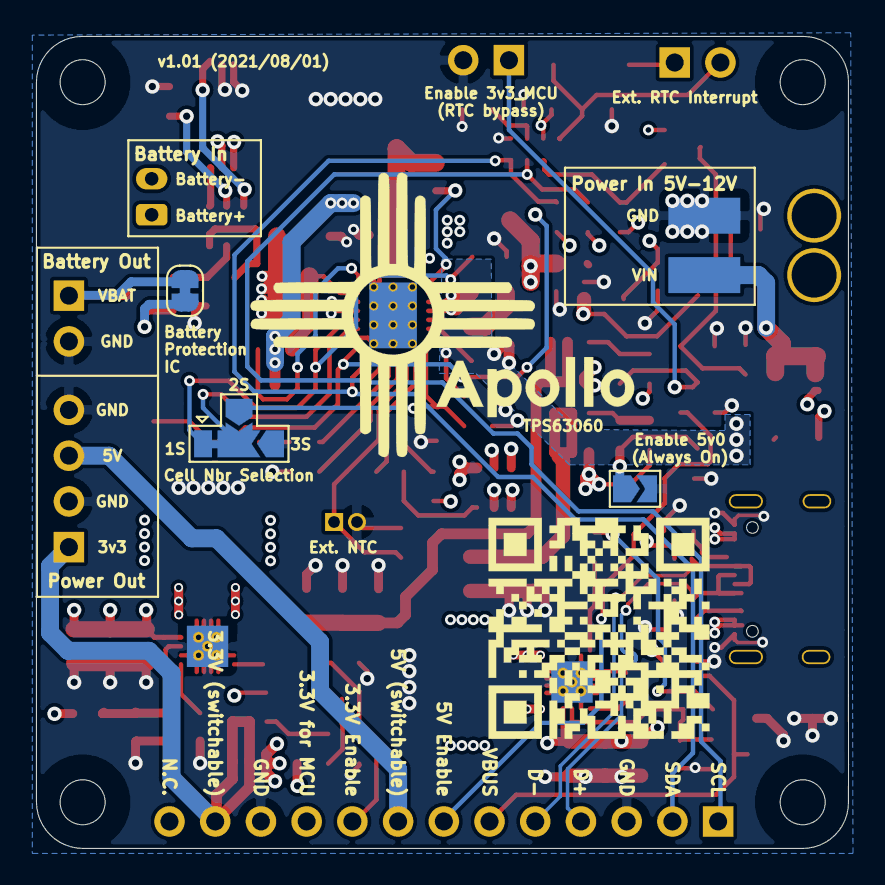
[picture p17: board SuperPower-uC-KiCad.kicad_pcb from below]

Board: 4 copper layers, 45.1 x 45.1 mm, 114 parts (4 on the bottom side), 65 nets.
