SuperPower/Apollo/(commit log)

2021-02-21 Move Repo and reduce project files to only contain the Apollo Board
    [BOM uC.xlsx, BOM.xlsx, DMP3028LSD-13.stp, JLCSMT_Sample_BOM1.xlsx, PJ-102AH--3DModel-STEP-56544.STEP, Pi-Batt.sch, Pi-Boost-Conv.sch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]
2021-02-22 Replace TPS63070 by TPS63060 (U9)
    - Schematic Only
    - Update Netlist
    Rem. : 18650 bat. holder + DC Power Jack + TP (x7) are added while update from schematic process.
    [BOM uC.xlsx, JLCSMT_Sample_BOM1.xlsx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]
2021-02-22 Remove unused parts at schematic level.
    + solve schematic DRC issues
    [SuperPower-uC-KiCad.kicad_pcb, battery_protection.sch, charger.sch, charger_io.sch, rtc_cut_off.sch]
2021-02-22 Place and route U9 (TPS63060)
    + re-place other parts
    + re-design planes shapes
    + display some silkscreen Ref. Des
    + misc. improvements.
    [SuperPower-uC-KiCad.kicad_pcb, regulator.sch]
2021-02-23 Add TPS63060 component files
    + 3D package
    [DSC0010E.stp, SuperPower-uC-KiCad.kicad_pcb, regulator.sch]
2021-02-24 Update 22µF 0805 & 100nF 0603 capacitors
    around TPS63060
    [SuperPower-uC-KiCad.kicad_pcb, regulator.sch]
2021-02-24 Update 10µF 0805 capacitors
    Around TPS63060
    [SuperPower-uC-KiCad.kicad_pcb, regulator.sch]
2021-02-24 Update 10pF 0603 capacitor
    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
    [SuperPower-uC-KiCad.kicad_pcb, regulator.sch]
2021-02-27 Place and route the 2nd TPS63060 (+5V)
    [SuperPower-uC-KiCad.kicad_pcb, regulator.sch]
2021-02-27 Update 22µF 0805 and 10pF 0603 capacitors
    + Silk Ref. Des.
    [SuperPower-uC-KiCad.kicad_pcb, regulator.sch]
2021-02-27 Update 10µF 0805 and 100nF 0603 capacitors
    + silk Ref. Des.
    Rem. : Apollo Logo and name on Silkscreen Bottom seem to be lost.
    [SuperPower-uC-KiCad.kicad_pcb, regulator.sch]
2021-02-28 Update +5V Buck-Boost Feedback resistor values
    [SuperPower-uC-KiCad.kicad_pcb, regulator.sch]
2021-02-28 Use a new footprint for TPS63060 chips
    Remove Bottom Soldermask on vias
    [SuperPower-uC-KiCad.kicad_pcb]
2021-02-28 Improve USB Data diff. Pair length.
    [SuperPower-uC-KiCad.kicad_pcb]
2021-02-28 Update Buck-Boost Feedback Resistor values
    - Use common values + bridge divider iq >3µA
    - Misc. Routing : increase one track width from 0.25 to 0.28mm (+5V Output)
    [SuperPower-uC-KiCad.kicad_pcb, regulator.sch]
2021-02-28 Update USB-C receptacle symbol fields
    Add Mfr Name & ref., DataSheet + Alternative Equivalent Part
    [SuperPower-uC-KiCad.kicad_pcb, charger_io.sch, regulator.sch]
2021-02-28 Re-Add "Apollo Logo" on Silkscreen bottom Layer
    [SuperPower-uC-KiCad.kicad_pcb]
2021-02-28 Update "RTC Bypass" text position
    + Add "-A" extension pour TPS63060 variant
    [SuperPower-uC-KiCad.kicad_pcb]
2021-03-01 Update Silkscreen board informations
    + Add a 12x12mm Text QR-Code
    [SuperPower-uC-KiCad.kicad_pcb]
2021-03-03 Replace Text Data QR Code by Web Link QR Code
    https://superpower.github.io/docs/uc/prod/apv100/
    [SuperPower-uC-KiCad.kicad_pcb]
2021-03-03 Replace QR-Code by 5x5mm size (x2)
    Web Link + Text Datas
    [SuperPower-uC-KiCad.kicad_pcb]
2021-03-08 Generated manufacturing files (deleted wrong gerbers)
    [BOM uC.xlsx, JLCSMT_Sample_BOM1.xlsx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]
2021-03-09 Update TPS63060 chips footprint
    Removing "Solder Mask Openings" between EPad pins for each row
    [SuperPower-uC-KiCad.kicad_pcb]
2021-03-09 Update QR-Code Web Link Size
    replace 5x5mm by 12x12mm
    [SuperPower-uC-KiCad.kicad_pcb]
2021-06-13 Recreate TPS709 symbol to and set footprint to SOT23-5
    [SuperPower-uC-KiCad.kicad_pcb, SuperPower-uC-KiCad.sch, regulator.sch, rtc_cut_off.sch]
2021-06-13 Connected VIN to I2C_REG
    [SuperPower-uC-KiCad.kicad_pcb]
2021-06-13 Swapped Q3 and Q15 Symbol + Footprint
    [SuperPower-uC-KiCad.kicad_pcb, charger.sch]
2021-06-13 Moved C3 closer to the LTC
    [SuperPower-uC-KiCad.kicad_pcb]
2021-07-19 Remove SMBALERT wire
    between LTC4162-L chip (pin12) and the 2.54mm pitch 13pin connector (pin13). It will allow to use this pin for "one wire" RGB LED (RGB LED Out)
    [SuperPower-uC-KiCad.kicad_pcb, charger.sch]
2021-07-19 Update SMBALERT LED (LED2) and resistor (R12) to DNP (Do Not Populate)
    [BOM uC.xlsx, BOM uC_save_01.xlsx, charger.sch]
2021-07-19 Add a Solder Jumper (shorted by default) between Vbat+ and R1 (AP9101)
    [SuperPower-uC-KiCad.kicad_pcb, battery_protection.sch]
2021-07-19 Clean "Battery Protection IC" schematic
    [SuperPower-uC-KiCad.kicad_pcb, battery_protection.sch]
2021-07-19 Update "Main Schematic" text
    [SuperPower-uC-KiCad.sch, battery_protection.sch]
2021-07-19 Update and clean "charger" sheet + add "Vcc" test point
    [SuperPower-uC-KiCad.kicad_pcb, charger.sch]
2021-07-19 Rename some power signal on Schematic to improve readability.
    + Misc. updates
    [SuperPower-uC-KiCad.kicad_pcb, SuperPower-uC-KiCad.sch, battery_protection.sch, charger.sch, charger_io.sch, regulator.sch, rtc_cut_off.sch]
2021-07-19 Improve Power tracks width on Bottom Layer
    [SuperPower-uC-KiCad.kicad_pcb]
2021-07-19 Improve Power Tracks width and Vias on Top Layer (+3.3V regulator)
    [SuperPower-uC-KiCad.kicad_pcb]
2021-07-19 Improve PowerTracks width and Vias on Top Layer (+5.0V)
    + Flip JP3
    [SuperPower-uC-KiCad.kicad_pcb]
2021-07-19 Improve Power Tracks width and Vias on Top Layer (+3.3V)
    [SuperPower-uC-KiCad.kicad_pcb]
2021-07-19 Improve Tracks width and vias around LTC4162-L
    [SuperPower-uC-KiCad.kicad_pcb]
2021-07-19 Improve Tracks width and Vias around LTC4162-L (Q3)
    [SuperPower-uC-KiCad.kicad_pcb, charger.sch]
2021-07-19 Q15 Track width issue correction
    [SuperPower-uC-KiCad.kicad_pcb, charger.sch]
2021-07-24 Flip JP1 Cell Number Selection (Top to bottom Layer)
    + Misc. Silkscreen updates
    [SuperPower-uC-KiCad.kicad_pcb]
2021-07-24 Update Silkscreen Bottom
    [SuperPower-uC-KiCad.kicad_pcb]
2021-07-24 Add 12x12mm QR Code (Web Link)
    [SuperPower-uC-KiCad.kicad_pcb]
2021-07-24 Update Silkscreen Layer Top
    [SuperPower-uC-KiCad.kicad_pcb]
2021-08-02 Add second 0805 resistor for Rsns (R20)
    - Add second 0805 resistor for Rsns (R20) and update values by 130 mOhm
    - Update Silkscreen layer (Ref Des. , text, etc.)
    [SuperPower-uC-KiCad.kicad_pcb, charger.sch]
2021-08-02 Move Silkscreen Text from via (Bottom Layer)
    [BOM uC.xlsx]
2021-08-02 Move Silkscreen Text from via (Bottom Layer)
    + Highlight New DNP items on XLS BOM file
    [SuperPower-uC-KiCad.kicad_pcb]
2021-08-03 Update 0805 resistor library link issue
    [charger.sch]
2021-08-04 MArked logos as virtual footprints to remove them from the bom
    [SuperPower-uC-KiCad.kicad_pcb]
2021-08-04 Created BOM
    [BOM uC.xlsx, BOM uC_save_01.xlsx, BOM.xlsx]
2021-08-04 Generated Gerber files incl. pos files and drilling
    [SuperPower-uC-KiCad-B_Cu.gbr, SuperPower-uC-KiCad-B_Mask.gbr, SuperPower-uC-KiCad-B_SilkS.gbr, SuperPower-uC-KiCad-Edge_Cuts.gbr, SuperPower-uC-KiCad-F_Cu.gbr, SuperPower-uC-KiCad-F_Mask.gbr, SuperPower-uC-KiCad-F_SilkS.gbr, SuperPower-uC-KiCad-In1_Cu.gbr]
2021-08-05 Update LED2 value as DNP + Manually Update BOM
    [BOM.xlsx, charger.sch]
