SuperPower/Apollo/(notices)

Notices in the files:
apollo-board_TPS63060/charger.sch:
Licence: CERN-OHL-W
